Giorgi1319/Current-sensing-circuit/README.md

# Current-sensing-circuit
4-layer MCU supply-current monitor: 1 Ω 0.1% shunt → INA821 in-amp → OPA365 driver → 16-bit 1 MSPS ADS8860 ADC with a REF6033 reference. 12 V input. OrCAD X 24.1 schematic and PCB, with JLCPCB-ready Gerbers and an LCSC BOM.

## PCB

| 3D top | 3D bottom |
|---|---|
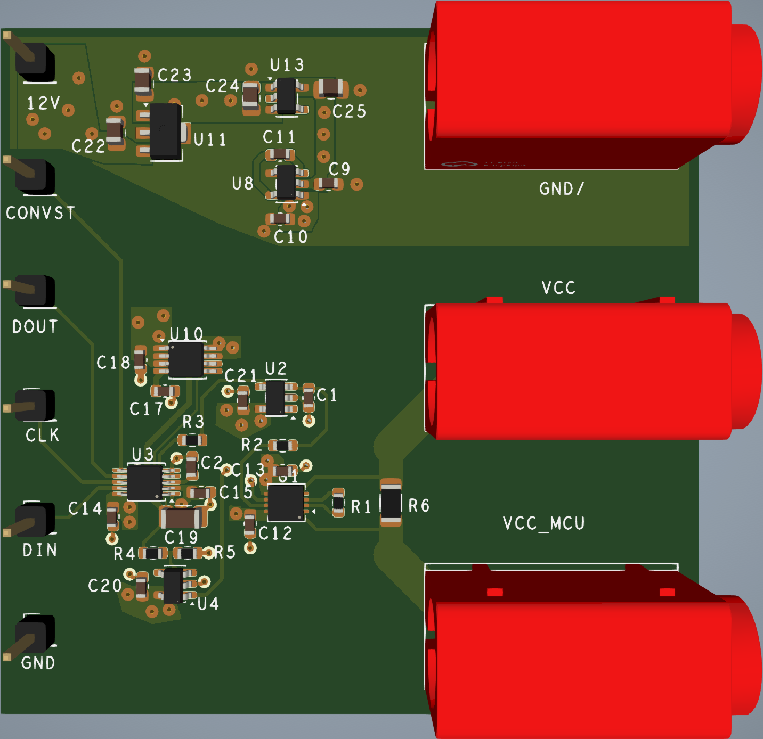
[picture p1: images/pcb_3d_top.png]
PCB 3D top
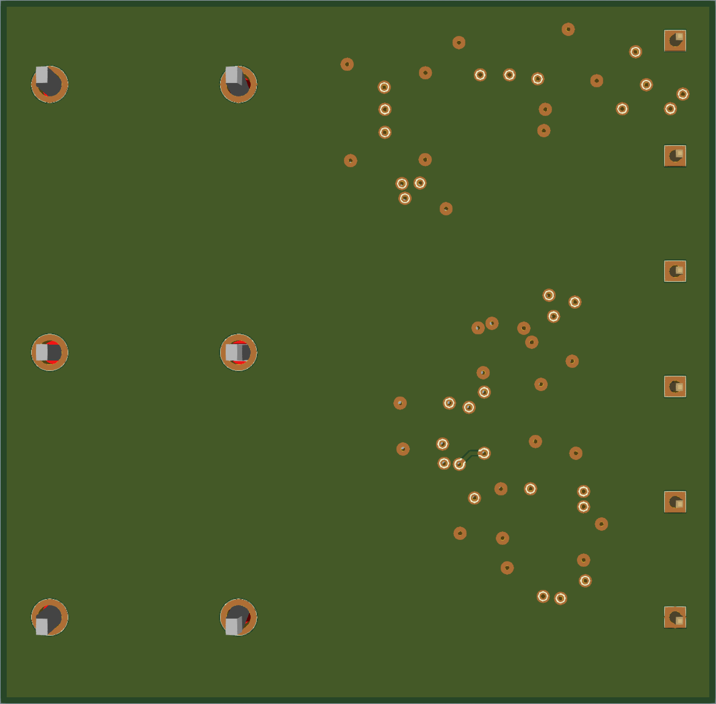
[picture p2: images/pcb_3d_bottom.png]
PCB 3D bottom
|  |  |

59.35 × 58.42 mm, 4 layers, 1.6 mm.

| L1 Top | L2 GND plane |
|---|---|
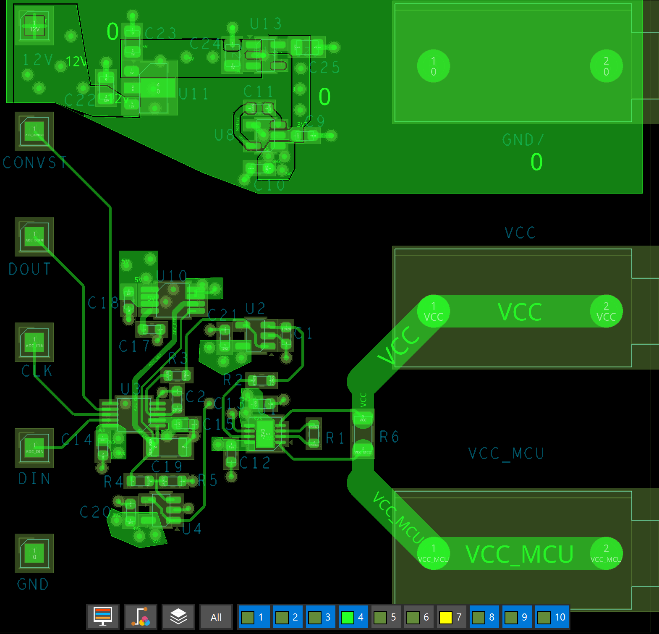
[picture p3: images/pcb_layer1_top.png]
Layer 1 top
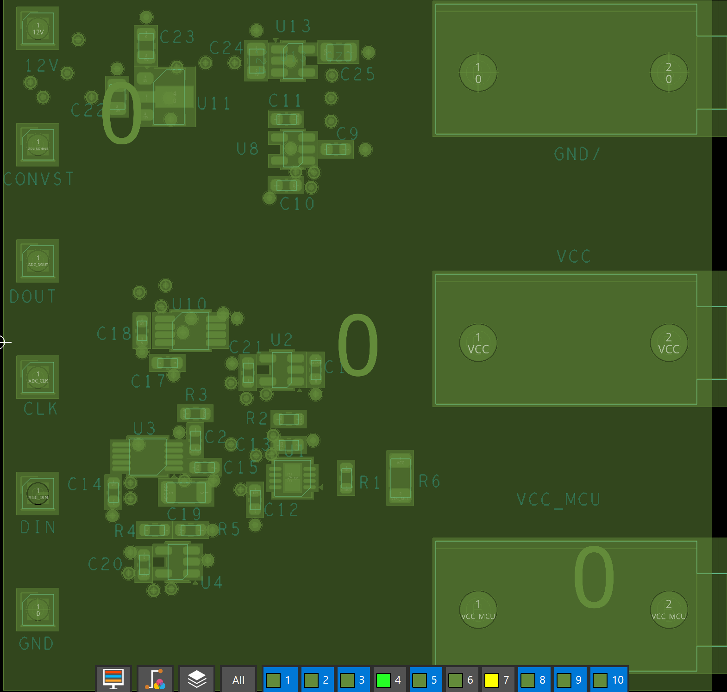
[picture p4: images/pcb_layer2_gnd_plane.png]
Layer 2 GND plane
|  |  |

| L3 Power (12V, 5V, 3V3, −3V3) | L4 Bottom (GND) |
|---|---|
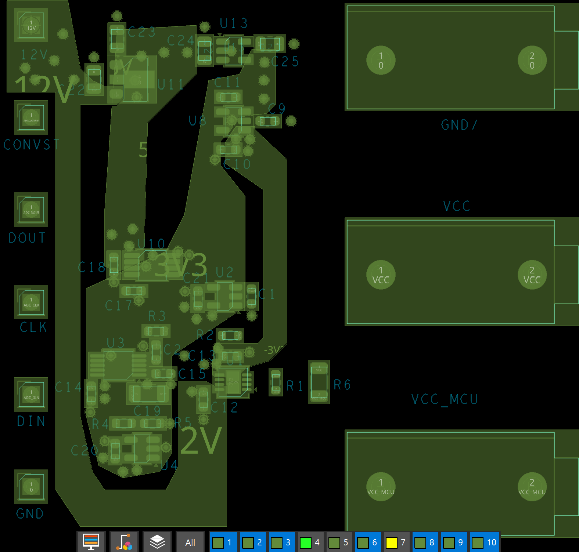
[picture p5: images/pcb_layer3_power.png]
Layer 3 power
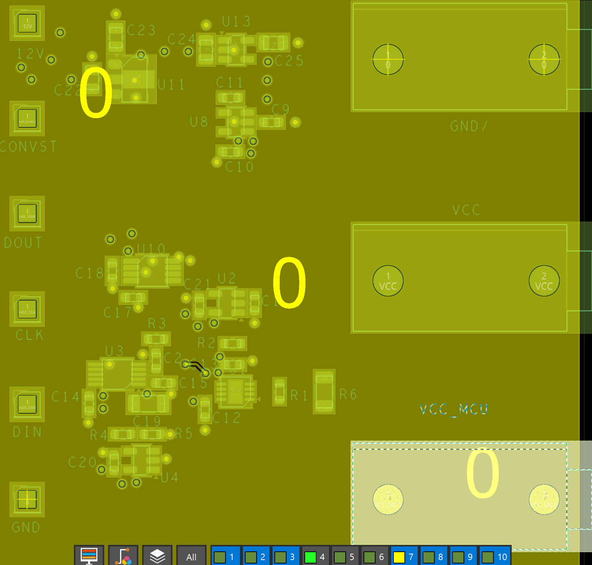
[picture p6: images/pcb_layer4_bottom.png]
Layer 4 bottom
|  |  |

## Schematic

**Signal chain:** shunt, INA821, OPA365 filter/driver and ADS8860 ADC
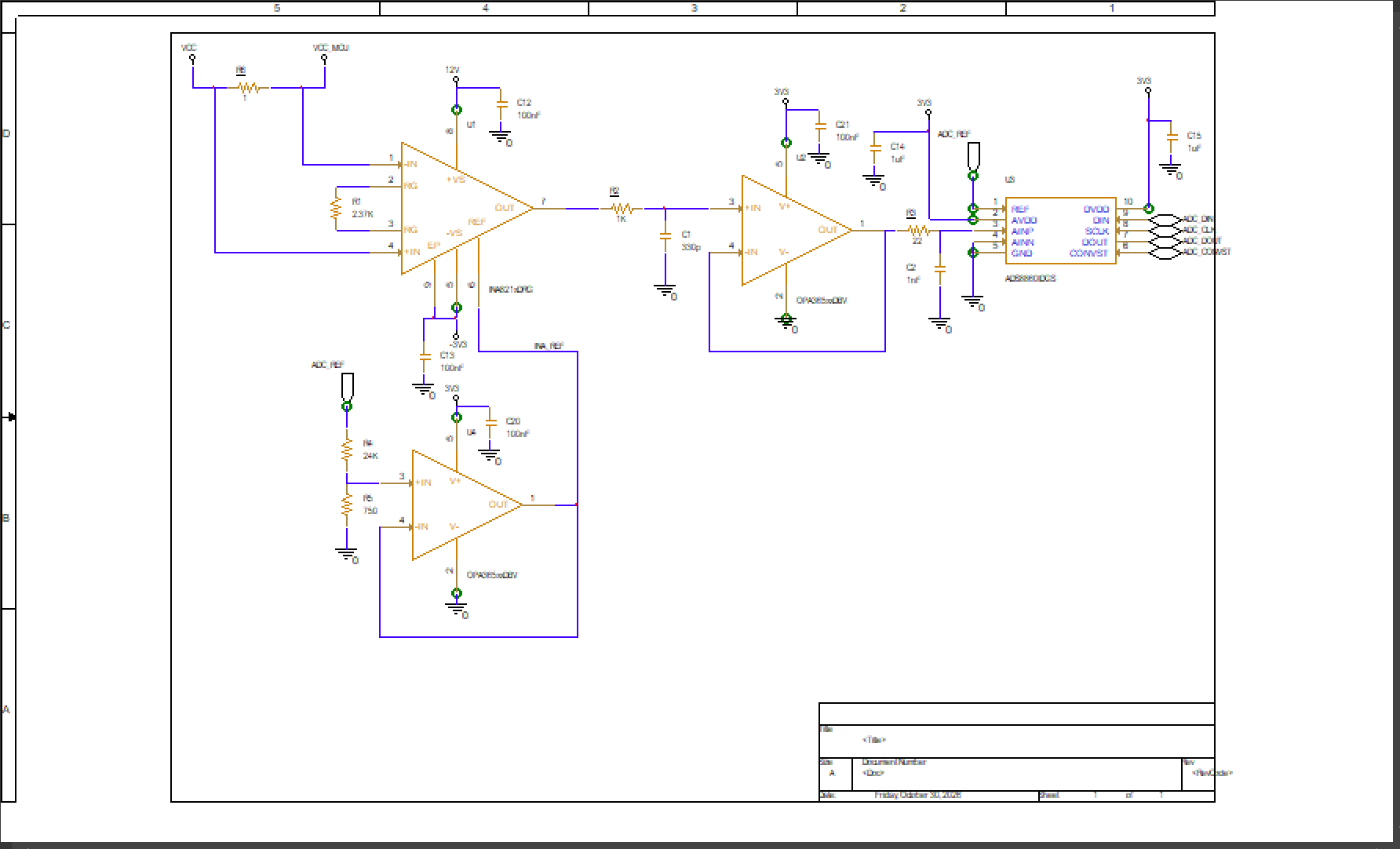
[picture p7: images/schematic_1_signal_chain.png]
Signal chain schematic


**ADC reference:** REF6033
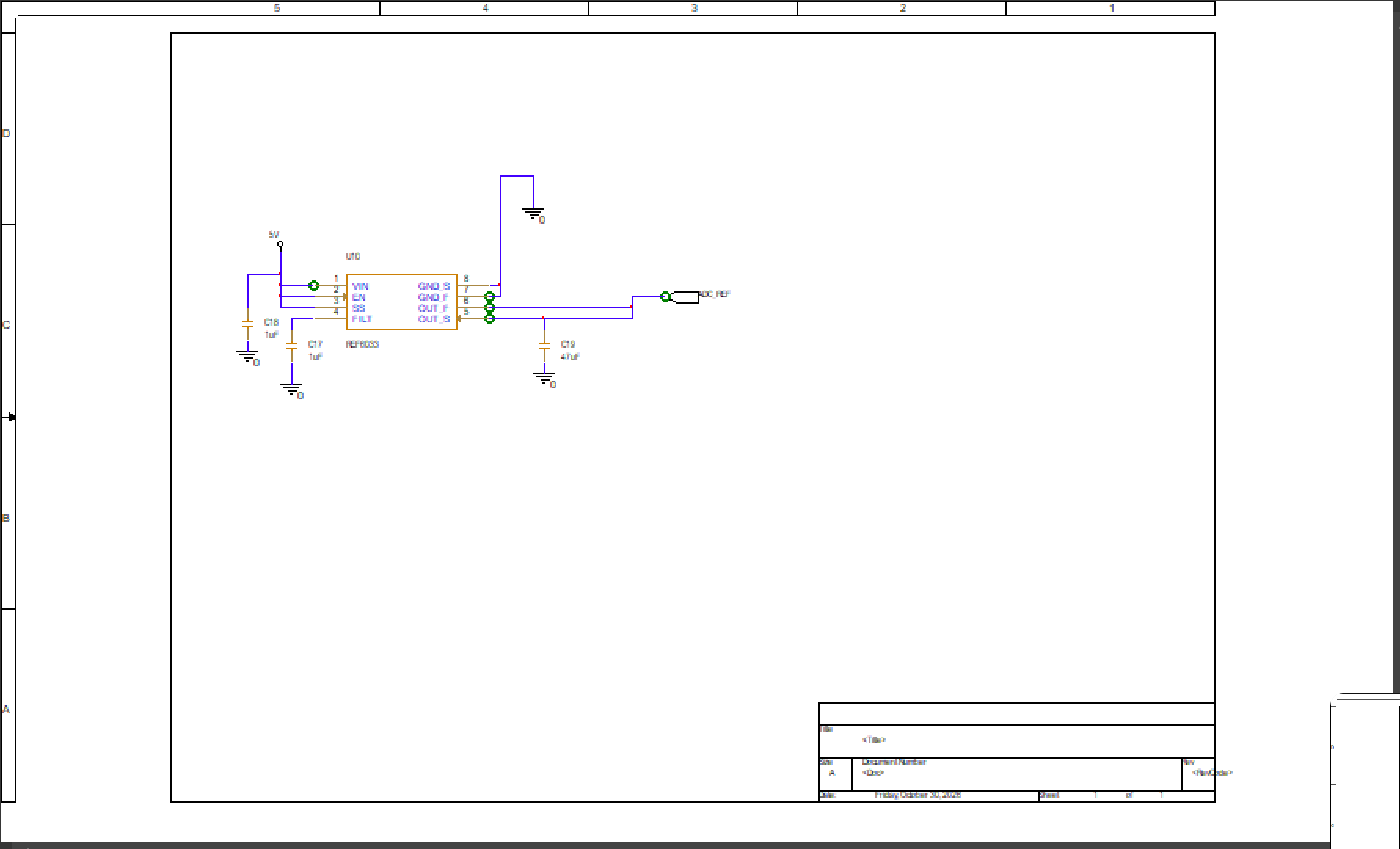
[picture p8: images/schematic_2_adc_reference.png]
ADC reference schematic


**Power and connectors:** 78L05, LP5907, TPS60403, headers and banana sockets
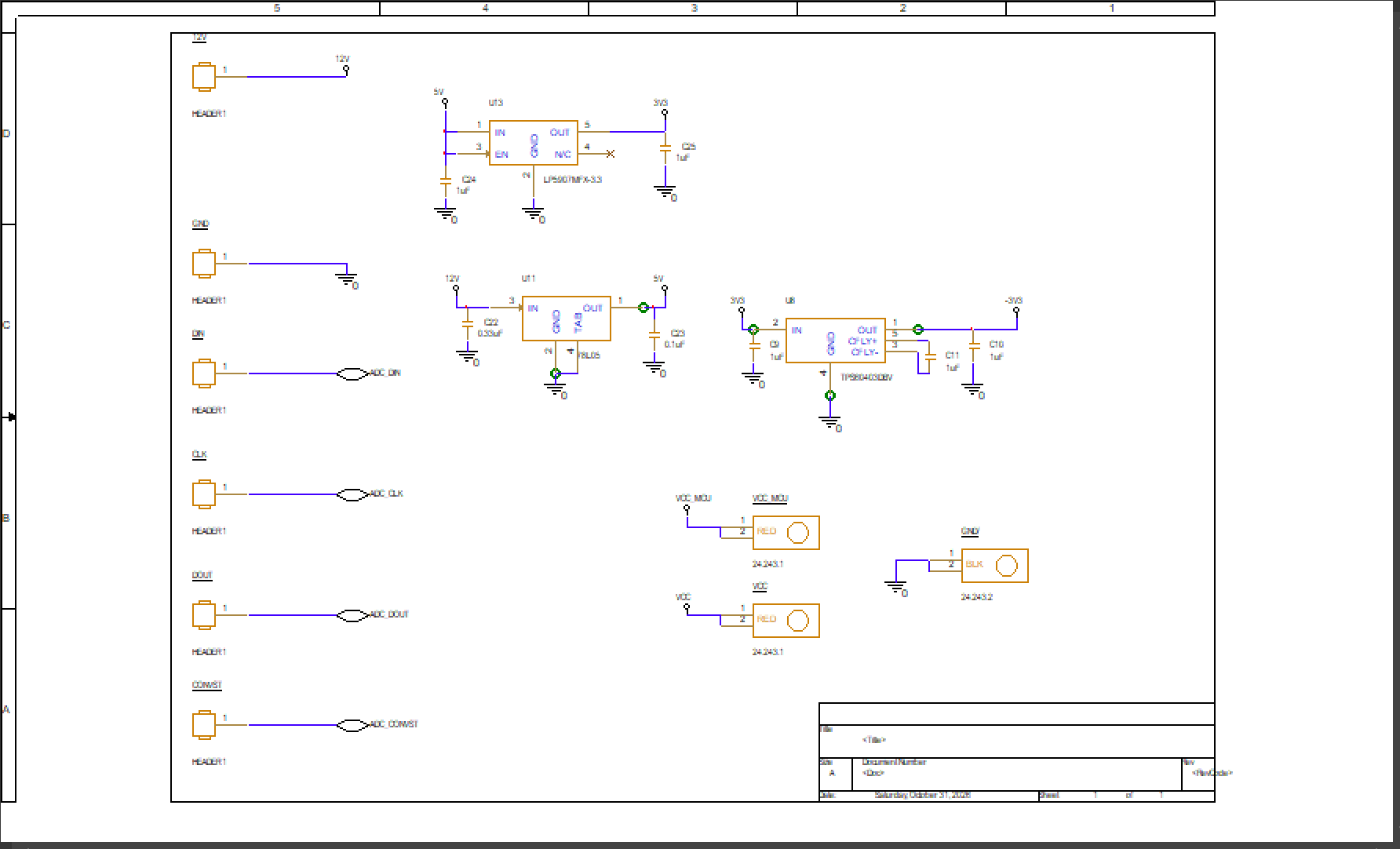
[picture p9: images/schematic_3_power_input.png]
Power and input schematic
