Giorgi1319/Current-sensing-circuit/current_sense/fab/current_sense_preview.png

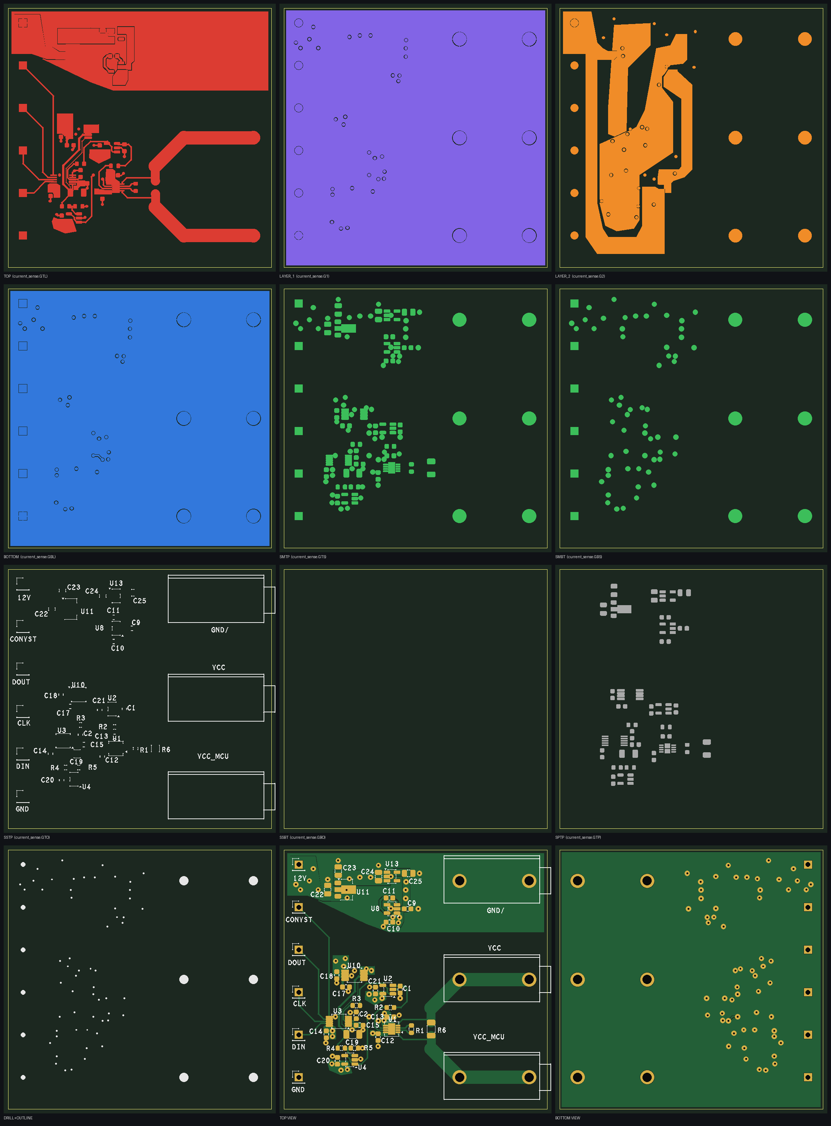
current_sense/fab/current_sense_preview.png
