Giorgi1319/Current-sensing-circuit/current_sense/current_sense_output/bom.sch.csv

Item Number | Quantity | Value | Description | Part Number | Part Reference | Manufacturer Name | Manufacturer Part Number | ID | SKU | ALT_MPN | ALT_MFR
1 | 1 | HEADER 1 |  |  | 12V |  |  | 226
2 | 1 | 330p |  |  | C1 |  |  | 58
3 | 1 | 1nF |  |  | C2 |  |  | 80
4 | 1 | 1uF |  |  | C9 |  |  | 235
5 | 1 | 1uF |  |  | C10 |  |  | 238
6 | 1 | 1uF |  |  | C11 |  |  | 242
7 | 1 | 100nF |  |  | C12 |  |  | 254
8 | 1 | 100nF |  |  | C13 |  |  | 257
9 | 1 | 1uF |  |  | C14 |  |  | 261
10 | 1 | 1uF |  |  | C15 |  |  | 264
11 | 1 | 1uF |  |  | C17 |  |  | 328
12 | 1 | 1uF |  |  | C18 |  |  | 333
13 | 1 | 47uF |  |  | C19 |  |  | 340
14 | 1 | 100nF |  |  | C20 |  |  | 344
15 | 1 | 100nF |  |  | C21 |  |  | 351
16 | 1 | 0.33uF |  |  | C22 |  |  | 372
17 | 1 | 0.1uF |  |  | C23 |  |  | 377
18 | 1 | 1uF |  |  | C24 |  |  | 405
19 | 1 | 1uF |  |  | C25 |  |  | 408
20 | 1 | HEADER 1 |  |  | CLK |  |  | 205
21 | 1 | HEADER 1 |  |  | CONVST |  |  | 209
22 | 1 | HEADER 1 |  |  | DIN |  |  | 203
23 | 1 | HEADER 1 |  |  | DOUT |  |  | 207
24 | 1 | 24.243.2 |  |  | GND/ |  |  | 276
25 | 1 | HEADER 1 |  |  | GND |  |  | 201
26 | 1 | 2.37K |  |  | R1 |  |  | 35
27 | 1 | 1K |  |  | R2 |  |  | 40
28 | 1 | 22 |  |  | R3 |  |  | 77
29 | 1 | 24K |  |  | R4 |  |  | 112
30 | 1 | 750 |  |  | R5 |  |  | 115
31 | 1 | 1 | 1R 0.1% 25ppm/C 250mW 1206 current-sense shunt |  | R6 |  |  | 2
32 | 1 | INA821xDRG |  |  | U1 |  |  | 20
33 | 1 | OPA365xxDBV |  |  | U2 |  |  | 68
34 | 1 | ADS8860IDGS |  |  | U3 |  |  | 84
35 | 1 | OPA365xxDBV |  |  | U4 |  |  | 106
36 | 1 | TPS60403DBV |  |  | U8 |  |  | 228
37 | 1 | REF6033 | 3.3V precision reference with integrated ADC drive buffer, VSSOP-8 |  | U10 |  |  | 310
38 | 1 | 78L05 |  |  | U11 |  |  | 365
39 | 1 | LP5907MFX-3.3 | 3.3V 250mA low-noise LDO, 5.5V max input, SOT-23-5 |  | U13 |  |  | 398
40 | 1 | 24.243.1 |  |  | VCC |  |  | 282
41 | 1 | 24.243.1 |  |  | VCC_MCU |  |  | 358
