Giorgi1319/Current-sensing-circuit/current_sense/fab/current_sense_BOM_LCSC.xlsx

Sheet: BOM
current_sense BOM with LCSC parts
Parts, stock and prices checked on lcsc.com on 2026-11-01. Order qty = qty per board x boards, rounded up to LCSC's minimum order and multiple; unit price is LCSC's price break for that qty.
Boards | 1 | <- edit the number of boards; order quantities and totals update.
Item | Designators | Qty / board | Value / description | Footprint | Manufacturer | MPN | LCSC part # | LCSC stock (2026-11-01) | Min order | Multiple | Order qty | Unit price ($) | Line total ($) | Notes
1 | U1 | 1 | INA821 instrumentation amplifier | WSON8_3X3_EP | TI | INA821IDRGT | C2864429 (https://www.lcsc.com/product-detail/C2864429.html) | 12 | 1 | 1 |  |  |  | Same chip and package as INA821IDRGR (C2864428), which is out of stock; only 12 left at LCSC.
2 | U2, U4 | 2 | OPA365 op amp, RRIO | SOT23_5 | TI | OPA365AIDBVR | C96626 (https://www.lcsc.com/product-detail/C96626.html) | 18067 | 1 | 1
3 | U3 | 1 | ADS8860 16-bit 1 MSPS SAR ADC | VSSOP10_3X3 | TI | ADS8860IDGSR | C2866559 (https://www.lcsc.com/product-detail/C2866559.html) | 95 | 1 | 1 |  |  |  | 95 in stock.
4 | U8 | 1 | TPS60403 charge-pump inverter (-3V3) | SOT23_5 | TI | TPS60403DBVR | C11338 (https://www.lcsc.com/product-detail/C11338.html) | 34639 | 1 | 1
5 | U10 | 1 | REF6033 3.3 V reference with buffer | VSSOP8_3X3 | TI | REF6033IDGKR | C2157005 (https://www.lcsc.com/product-detail/C2157005.html) | 15 | 1 | 1 |  |  |  | Only 15 in stock.
6 | U11 | 1 | 78L05 5 V regulator | SOT89_TAB4 | UMW | 78L05 | C347258 (https://www.lcsc.com/product-detail/C347258.html) | 757980 | 20 | 20 |  |  |  | Minimum order 20.
7 | U13 | 1 | LP5907 3.3 V LDO | SOT23_5 | TI | LP5907MFX-3.3/NOPB | C80670 (https://www.lcsc.com/product-detail/C80670.html) | 57640 | 5 | 5
8 | R1 | 1 | 2.37 kΩ 0.1% 25 ppm thin film (INA821 gain) | R0603 | UNI-ROYAL | TC0325B2371T5F | C50670507 (https://www.lcsc.com/product-detail/C50670507.html) | 4700 | 50 | 50 |  |  |  | Sets the INA821 gain. 1% thick-film option: C25964 (0603WAF2371T5E).
9 | R2 | 1 | 1 kΩ 1% | R0603 | UNI-ROYAL | 0603WAF1001T5E | C21190 (https://www.lcsc.com/product-detail/C21190.html) | 5096000 | 100 | 100
10 | R3 | 1 | 22 Ω 1% | R0603 | UNI-ROYAL | 0603WAF220JT5E | C23345 (https://www.lcsc.com/product-detail/C23345.html) | 2979800 | 100 | 100
11 | R4 | 1 | 24 kΩ 0.1% 25 ppm thin film | R0603 | YAGEO | RT0603BRD0724KL | C326729 (https://www.lcsc.com/product-detail/C326729.html) | 41860 | 20 | 20 |  |  |  | Divider from ADC_REF. 1% option: C23352 (0603WAF2402T5E).
12 | R5 | 1 | 750 Ω 0.1% 25 ppm thin film | R0603 | YAGEO | RT0603BRD07750RL | C861551 (https://www.lcsc.com/product-detail/C861551.html) | 60 | 20 | 20 |  |  |  | Divider from ADC_REF; only 60 in stock. 1% option: C23241 (0603WAF7500T5E).
13 | R6 | 1 | 1 Ω 0.1% 25 ppm 250 mW current shunt | R1206 | Milliohm | HoAR1206-1/4W-1R-0.1%-TCR25 | C2912606 (https://www.lcsc.com/product-detail/C2912606.html) | 11955 | 5 | 5
14 | C1 | 1 | 330 pF 50 V C0G | C0603 | Samsung Electro-Mechanics | CL10C331JB8NNNC | C1664 (https://www.lcsc.com/product-detail/C1664.html) | 100850 | 50 | 50
15 | C2 | 1 | 1 nF 50 V C0G | C0603 | Samsung Electro-Mechanics | CL10C102JB8NNNC | C163508 (https://www.lcsc.com/product-detail/C163508.html) | 367500 | 50 | 50 |  |  |  | ADC input charge-kickback cap; must stay C0G.
16 | C9, C10, C11, C14, C15, C17, C18 | 7 | 1 µF 25 V X7R | C0603 | Samsung Electro-Mechanics | CL10B105KA8NNNC | C29936 (https://www.lcsc.com/product-detail/C29936.html) | 332090 | 10 | 10
17 | C12, C13, C20, C21 | 4 | 100 nF 50 V X7R | C0603 | Samsung Electro-Mechanics | CL10B104KB8NNNC | C1591 (https://www.lcsc.com/product-detail/C1591.html) | 1813600 | 100 | 100 |  |  |  | C12 is on 12V.
18 | C19 | 1 | 47 µF 10 V X5R | C1206 | Samsung Electro-Mechanics | CL31A476MPHNNNE | C96123 (https://www.lcsc.com/product-detail/C96123.html) | 135335 | 5 | 5 |  |  |  | REF6033 output cap (ADC_REF).
19 | C22 | 1 | 330 nF 50 V X7R | C0805 | Samsung Electro-Mechanics | CL21B334KBFNNNE | C73142 (https://www.lcsc.com/product-detail/C73142.html) | 12400 | 50 | 50 |  |  |  | 78L05 input, on 12V.
20 | C23 | 1 | 100 nF 50 V X7R | C0805 | YAGEO | CC0805KRX7R9BB104 | C49678 (https://www.lcsc.com/product-detail/C49678.html) | 9236500 | 20 | 20
21 | C24, C25 | 2 | 1 µF 50 V X7R | C0805 | YAGEO | CC0805KKX7R9BB105 | C91185 (https://www.lcsc.com/product-detail/C91185.html) | 221760 | 20 | 20
22 | VCC, VCC_MCU | 2 | 4 mm banana socket, right angle, red | BANANA_24243 | Changzhou Amass Elec | 24.243.1 | C7437321 (https://www.lcsc.com/product-detail/C7437321.html) | 5371 | 1 | 1
23 | GND/ | 1 | 4 mm banana socket, right angle, black | BANANA_24243 | Changzhou Amass Elec | 24.243.2 | C7437322 (https://www.lcsc.com/product-detail/C7437322.html) | 3163 | 1 | 1
24 | 12V, CONVST, DOUT, CLK, DIN, GND | 1 | 2.54 mm pin header, 1x40 strip | HDR1X01_254 | BOOMELE(Boom Precision Elec) | 2.54-1*40P | C2337 (https://www.lcsc.com/product-detail/C2337.html) | 62635 | 5 | 5 |  |  |  | One strip per board: cut 6 single pins from it.
 | Total |  | purchase units per board (header strip counts as 1) |  |  |  |  |  |  |  |  | Total ($)
 | Excludes shipping and tax. Orange stock cells: under 100 left at LCSC.

Sheet: Price breaks
LCSC price breaks per part, read from lcsc.com on 2026-11-01 (USD, per piece).
LCSC part # | Qty break 1 | Qty break 2 | Qty break 3 | Qty break 4 | Qty break 5 | Qty break 6 | Price 1 ($) | Price 2 ($) | Price 3 ($) | Price 4 ($) | Price 5 ($) | Price 6 ($)
C2864429 | 1 | 10 | 30 | 100 |  |  | 9.3806 | 8.1138 | 7.3419 | 6.6946
C96626 | 1 | 10 | 30 | 100 | 500 | 1000 | 2.8601 | 2.5707 | 2.3655 | 2.1786 | 2.0926 | 2.0579
C2866559 | 1 | 10 | 30 | 100 |  |  | 16.5353 | 14.9407 | 14.3633 | 13.2153
C11338 | 1 | 10 | 30 | 100 | 500 | 1000 | 0.7202 | 0.6018 | 0.5180 | 0.4489 | 0.4407 | 0.4275
C2157005 | 1 | 10 | 30 | 100 |  |  | 8.5657 | 7.3225 | 6.5636 | 5.9287
C347258 | 20 | 200 | 1000 | 2000 | 10000 | 20000 | 0.0380 | 0.0280 | 0.0236 | 0.0203 | 0.0189 | 0.0181
C80670 | 5 | 50 | 150 | 500 | 3000 | 6000 | 0.1668 | 0.1286 | 0.1100 | 0.0934 | 0.0888 | 0.0861
C50670507 | 50 | 500 | 1500 | 5000 |  |  | 0.0099 | 0.0097 | 0.0095 | 0.0094
C21190 | 100 | 1000 | 5000 | 10000 | 50000 |  | 0.0017 | 0.0014 | 0.0012 | 0.0010 | 0.0009
C23345 | 100 | 1000 | 5000 | 10000 | 50000 |  | 0.0017 | 0.0014 | 0.0012 | 0.0011 | 0.0010
C326729 | 20 | 200 | 600 | 5000 | 10000 | 20000 | 0.0376 | 0.0320 | 0.0289 | 0.0270 | 0.0254 | 0.0245
C861551 | 20 | 200 | 600 | 5000 | 10000 | 20000 | 0.0441 | 0.0378 | 0.0343 | 0.0322 | 0.0303 | 0.0294
C2912606 | 5 | 50 | 150 | 500 | 2500 | 5000 | 0.1468 | 0.1267 | 0.1167 | 0.1091 | 0.0700 | 0.0670
C1664 | 50 | 500 | 1500 | 4000 | 24000 | 48000 | 0.0182 | 0.0144 | 0.0123 | 0.0100 | 0.0089 | 0.0083
C163508 | 50 | 500 | 1500 | 4000 | 24000 | 48000 | 0.0091 | 0.0069 | 0.0059 | 0.0052 | 0.0050 | 0.0048
C29936 | 10 | 100 | 300 | 1000 | 4000 | 8000 | 0.0179 | 0.0140 | 0.0123 | 0.0111 | 0.0089 | 0.0086
C1591 | 100 | 1000 | 4000 | 8000 | 48000 | 100000 | 0.0075 | 0.0057 | 0.0049 | 0.0044 | 0.0041 | 0.0039
C96123 | 5 | 50 | 150 | 500 | 2000 | 4000 | 0.1728 | 0.1360 | 0.1181 | 0.1020 | 0.0863 | 0.0837
C73142 | 50 | 500 | 2000 | 4000 | 24000 | 50000 | 0.0244 | 0.0201 | 0.0177 | 0.0163 | 0.0150 | 0.0144
C49678 | 20 | 200 | 600 | 4000 | 8000 | 20000 | 0.0206 | 0.0156 | 0.0128 | 0.0108 | 0.0093 | 0.0086
C91185 | 20 | 200 | 600 | 3000 | 9000 | 21000 | 0.0350 | 0.0282 | 0.0244 | 0.0221 | 0.0201 | 0.0190
C7437321 | 1 | 10 | 250 | 1000 |  |  | 0.4193 | 0.3947 | 0.3322 | 0.3207
C7437322 | 1 | 10 | 250 | 1000 |  |  | 0.4193 | 0.3946 | 0.3338 | 0.3206
C2337 | 5 | 50 | 150 | 500 | 2500 | 5000 | 0.1607 | 0.1344 | 0.1209 | 0.0922 | 0.0884 | 0.0857

Sheet: LCSC upload
For lcsc.com's BOM tool (upload this sheet, or paste the two columns). Quantities follow the Boards cell on the BOM sheet.
LCSC Part Number | Quantity | Manufacturer Part Number | Designators
