Giorgi1319/Current-sensing-circuit/current_sense/step/sot223_tab4.step

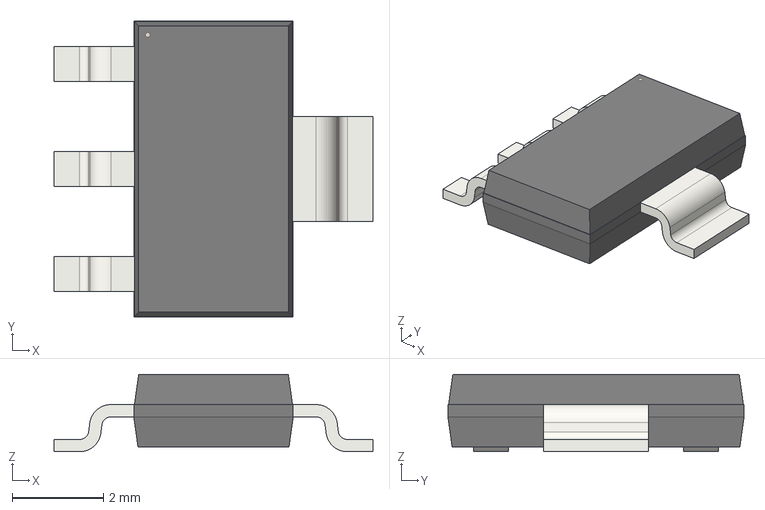
[picture p11: CAD file, 2026-11-03]
current_sense/step/sot223_tab4.step
7.00 x 6.50 x 1.70 mm
