Giorgi1319/Current-sensing-circuit/current_sense/step/hdr1x01_254.step

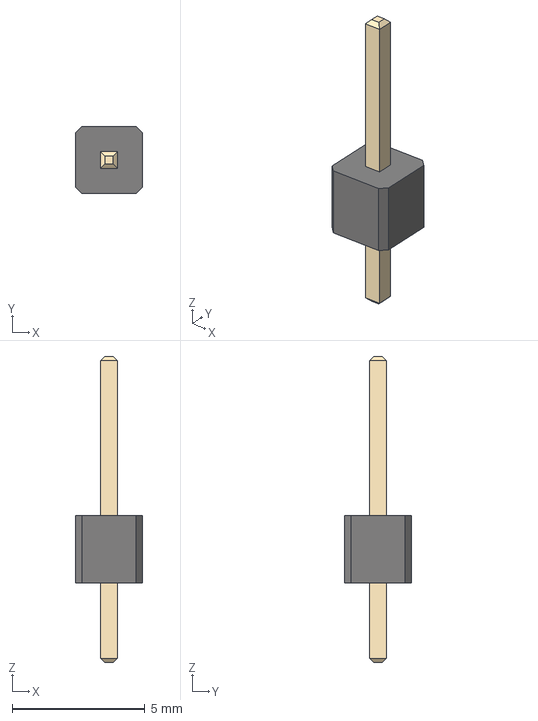
[picture p12: CAD file, 2026-11-03]
current_sense/step/hdr1x01_254.step
2.54 x 2.54 x 11.5 mm
