Giorgi1319/Current-sensing-circuit/current_sense/step/vssop10_3x3.step

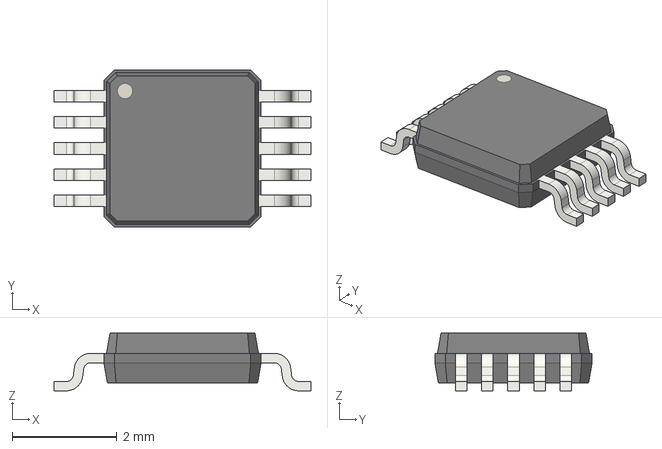
[picture p13: CAD file, 2026-11-03]
current_sense/step/vssop10_3x3.step
4.90 x 3.00 x 1.10 mm
