Giorgi1319/Current-sensing-circuit/current_sense/step/r1206.step

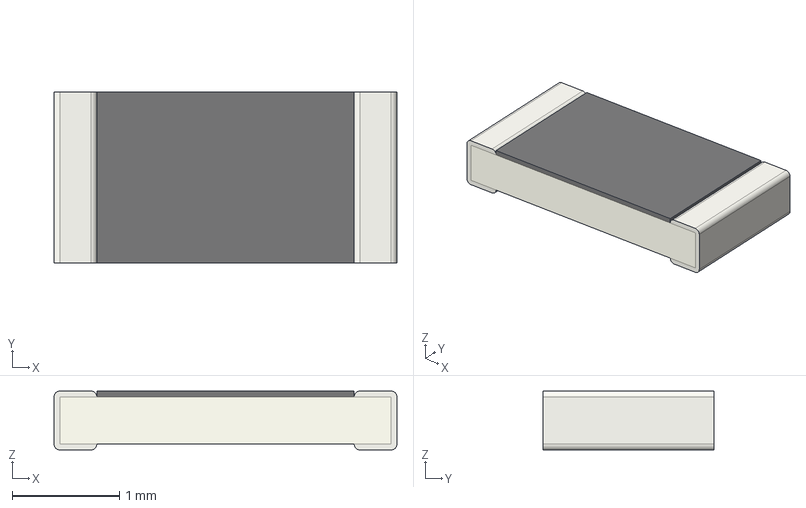
[picture p14: CAD file, 2026-11-03]
current_sense/step/r1206.step
3.20 x 1.60 x 0.55 mm
