Giorgi1319/Current-sensing-circuit/current_sense/step/wson8_3x3_ep.step

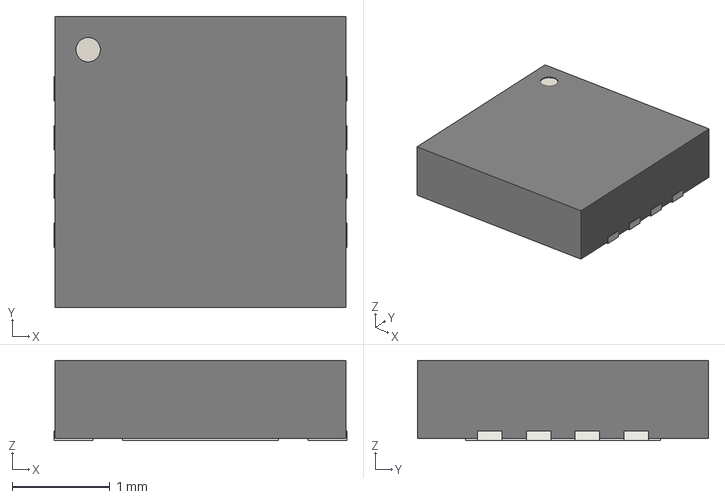
[picture p15: CAD file, 2026-11-03]
current_sense/step/wson8_3x3_ep.step
3.00 x 2.98 x 0.82 mm
