Giorgi1319/Current-sensing-circuit/current_sense/step/c0805.step

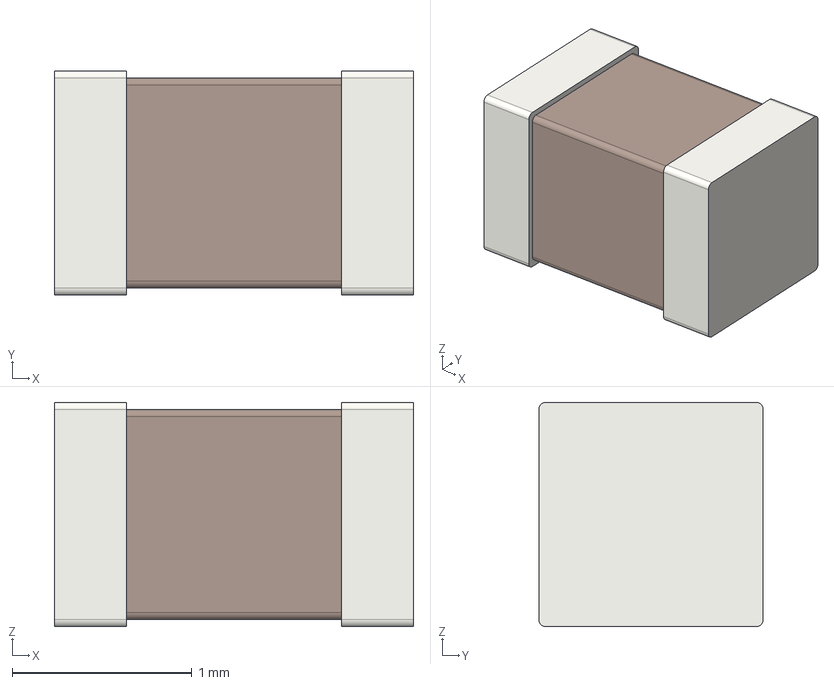
[picture p16: CAD file, 2026-11-03]
current_sense/step/c0805.step
2.00 x 1.25 x 1.25 mm
