Giorgi1319/Current-sensing-circuit/current_sense/step/vssop8_3x3.step

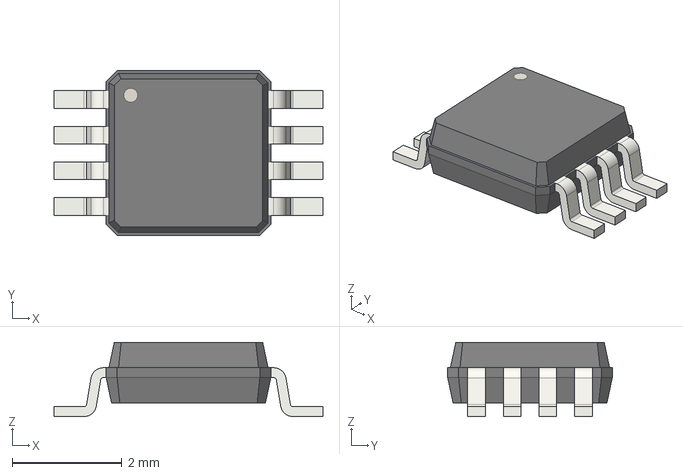
[picture p17: CAD file, 2026-11-03]
current_sense/step/vssop8_3x3.step
4.90 x 3.00 x 1.35 mm
