Giorgi1319/Current-sensing-circuit/current_sense/step/c1206.step

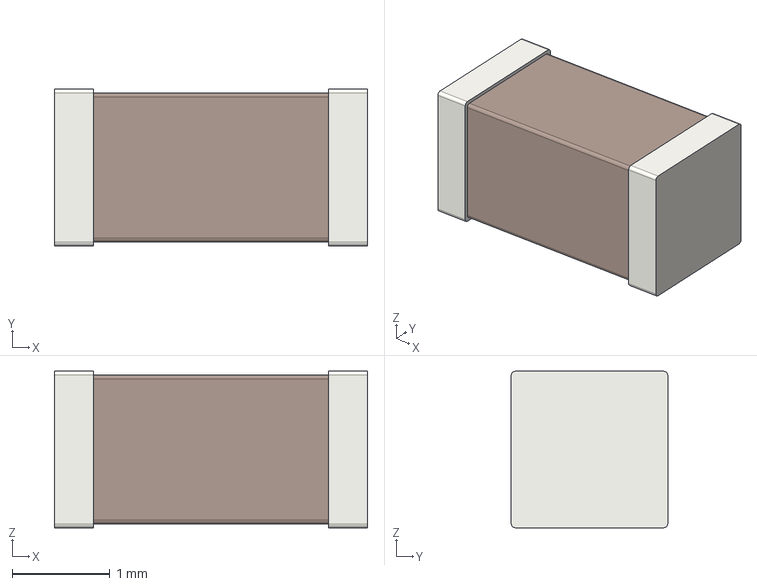
[picture p18: CAD file, 2026-11-03]
current_sense/step/c1206.step
3.20 x 1.60 x 1.60 mm
