Giorgi1319/Current-sensing-circuit/current_sense/step/banana_24243.step

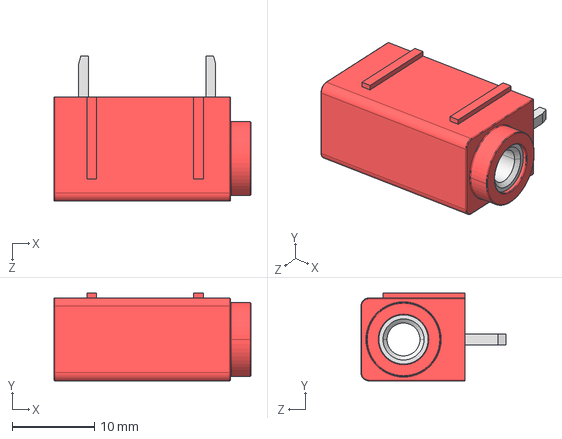
[picture p19: CAD file, 2026-11-03]
current_sense/step/banana_24243.step
24.0 x 10.7 x 17.7 mm
