Giorgi1319/Current-sensing-circuit/current_sense/step/c0603.step

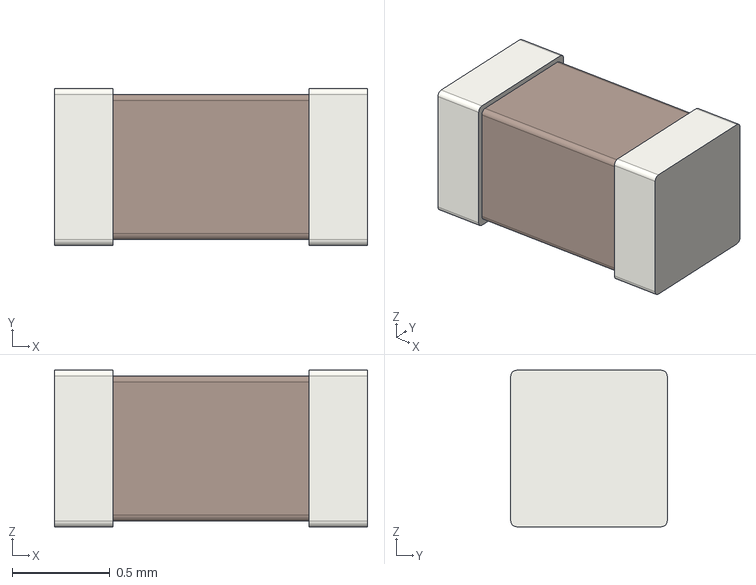
[picture p21: CAD file, 2026-11-03]
current_sense/step/c0603.step
1.60 x 0.8 x 0.8 mm
