Giorgi1319/Current-sensing-circuit/current_sense/step/sot23_5.step

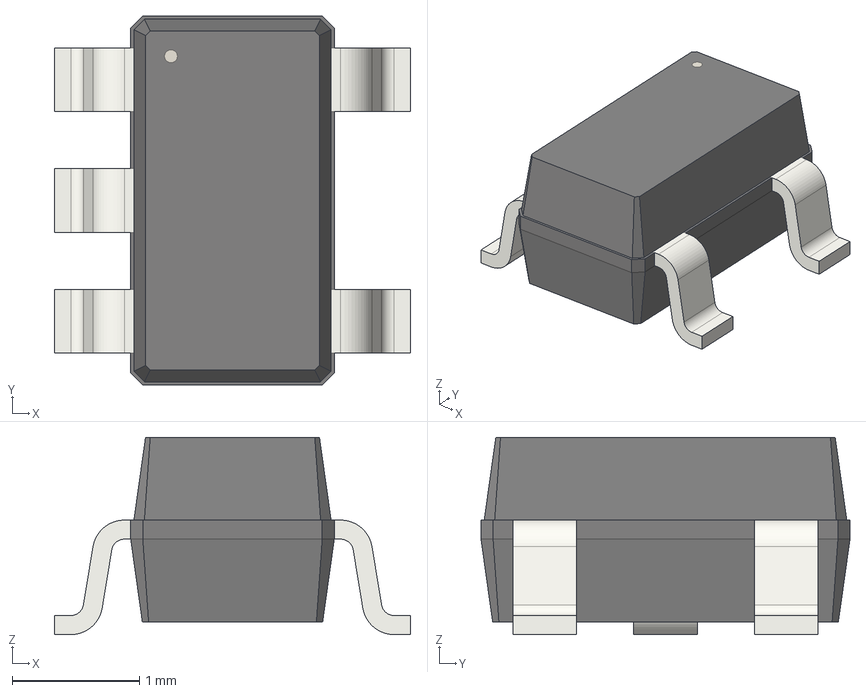
[picture p22: CAD file, 2026-11-03]
current_sense/step/sot23_5.step
2.80 x 2.90 x 1.55 mm
