Giorgi1319/Current-sensing-circuit/current_sense/step/sot89_tab4.step

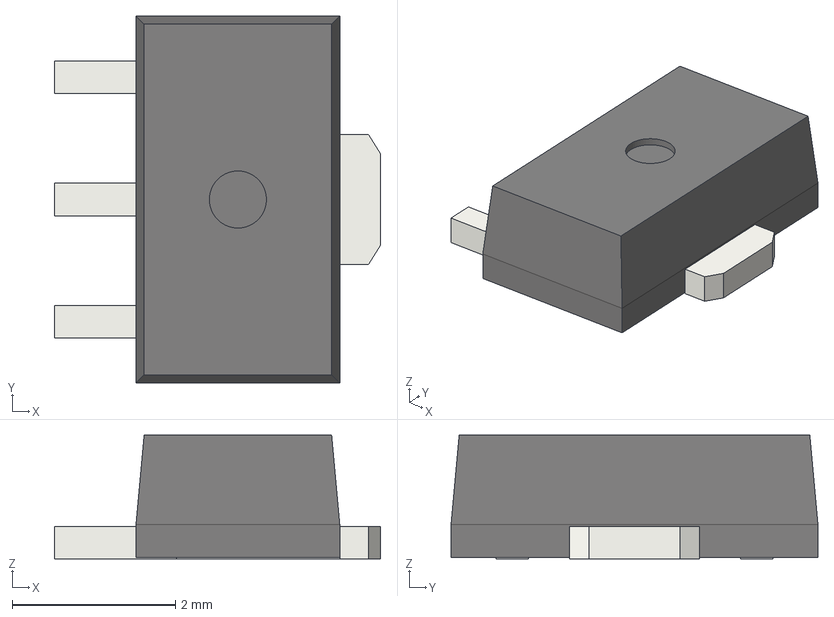
[picture p23: CAD file, 2026-11-03]
current_sense/step/sot89_tab4.step
4.00 x 4.50 x 1.52 mm
adbeea57-9c39-11ed-93f0-dde97e994e83_part
adbeea58-9c39-11ed-93f0-dde97e994e83_part
adbeea59-9c39-11ed-93f0-dde97e994e83_part
