Giorgi1319/Current-sensing-circuit/(list of files, cad)

Other CAD files:
current_sense/symbols.before-3d/banana_24243.psm
current_sense/symbols.before-3d/c0603.psm
current_sense/symbols.before-3d/c0805.psm
current_sense/symbols.before-3d/c1206.psm
current_sense/symbols.before-3d/hdr1x01_254.psm
current_sense/symbols.before-3d/r0603.psm
current_sense/symbols.before-3d/r1206.psm
current_sense/symbols.before-3d/sot223_tab4.psm
current_sense/symbols.before-3d/sot23_5.psm
current_sense/symbols.before-3d/vssop10_3x3.psm
current_sense/symbols.before-3d/vssop8_3x3.psm
current_sense/symbols.before-3d/wson8_3x3_ep.psm
current_sense/symbols/banana_24243.psm
current_sense/symbols/c0603.psm
current_sense/symbols/c0805.psm
current_sense/symbols/c1206.psm
current_sense/symbols/hdr1x01_254.psm
current_sense/symbols/r0603.psm
current_sense/symbols/r1206.psm
current_sense/symbols/sot223_tab4.psm
current_sense/symbols/sot23_5.psm
current_sense/symbols/sot89_tab4.psm
current_sense/symbols/vssop10_3x3.psm
current_sense/symbols/vssop8_3x3.psm
current_sense/symbols/wson8_3x3_ep.psm
