Giorgi1319/Current-sensing-circuit/(list of files, drawings)

Other design files:
current_sense/CURRENT_SENSE.DSN
current_sense/current_sense.opj
current_sense/CURRENT_SENSE_PARTS.OLB
