Giorgi1319/Current-sensing-circuit/(notices)

Notices in the files:
current_sense/step/c1206.step:
Copyright (C) 2017, kicad StepUp
This work is licensed under the [Creative Commons CC-BY-SA 4.0 License](https://creativecommons.org/licenses/by-sa/4.0/legalcode),
with the following exception:
To the extent that the creation of electronic designs that use 'Licensed Material' can be considered to be 'Adapted Material',
You are free to use the library data in your own projects without the obligation to share your project files under this or any other license agreement.
current_sense/step/r0603.step:
Copyright (C) 2018, kicad StepUp
current_sense/step/sot89_tab4.step:
Copyright (C) 2023, Ray Benitez
This work is licensed under the
[Creative Commons CC-BY-SA 4.0 License](https://creativecommons.org/licenses/by-sa/4.0/legalcode),
project files under this or any other license agreement. However, if you wish to distribute
current_sense/step/sot223_tab4.step:
Copyright (C) 2025, KiCAD
current_sense/step/vssop10_3x3.step:
Copyright (C) 2026, KiCAD
